fuganater/OpenWinder/wiring.png

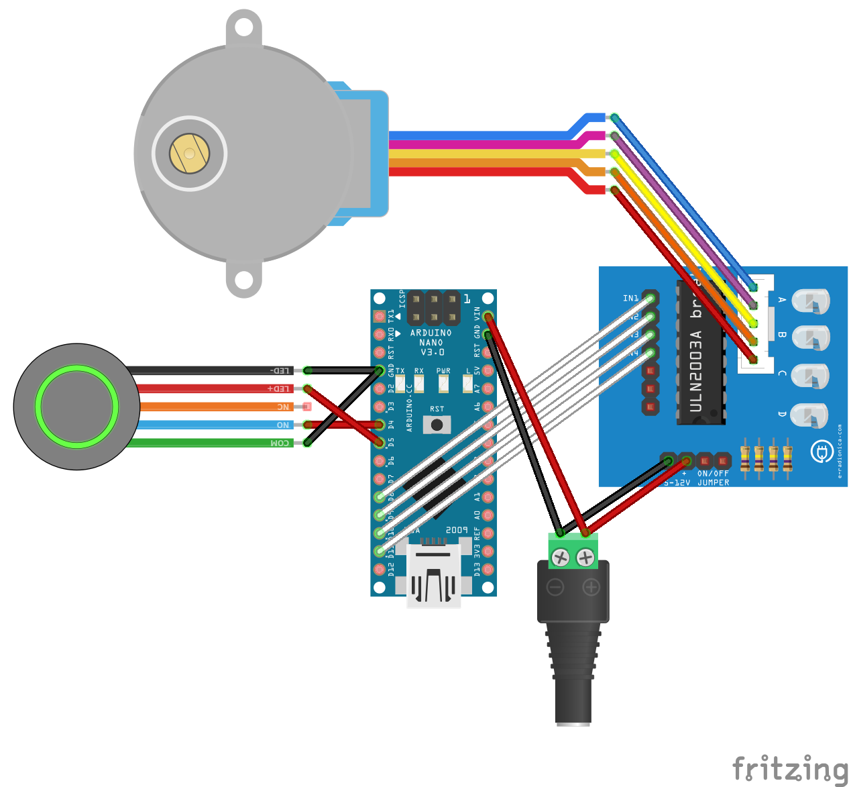
wiring.png
