fuganater/OpenWinder/(threads)

Thread 1 (2023-04-01):

Code

ruiferre, 2023-04-01:
Hello. When i copy/paste the code i have errors. Can you help?
Thanks

F:\Arduino\Watch Winder\OpenWinder-master\OpenWatchWinder\OpenWatchWinder.ino:17:10: fatal error: jled.h: No such file or directory
 #include <jled.h>
          ^~~~~~~~
compilation terminated.

exit status 1

Compilation error: jled.h: No such file or directory

albiper, 2023-07-10:
Include JLed library
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
