fuganater/OpenWinder/(commit log)

2019-05-01 Don't restart automatically after stopping with button.
2019-05-01 rename add wiring diagram
2019-05-02 add BOM to README
2019-05-02 add LED toggle via double-click
2019-05-02 don't start short blinking when already stopped
    [OpenWatchWinder.ino]
2019-05-02 ... but do switch LED to On if waiting and being stopped
2019-05-11 swap rotation and cycle count for faster stopping
    [OpenWatchWinder.ino]
